wagiminator/ATtiny13-TinyDice/documentation/TinyDice_pic2.jpg

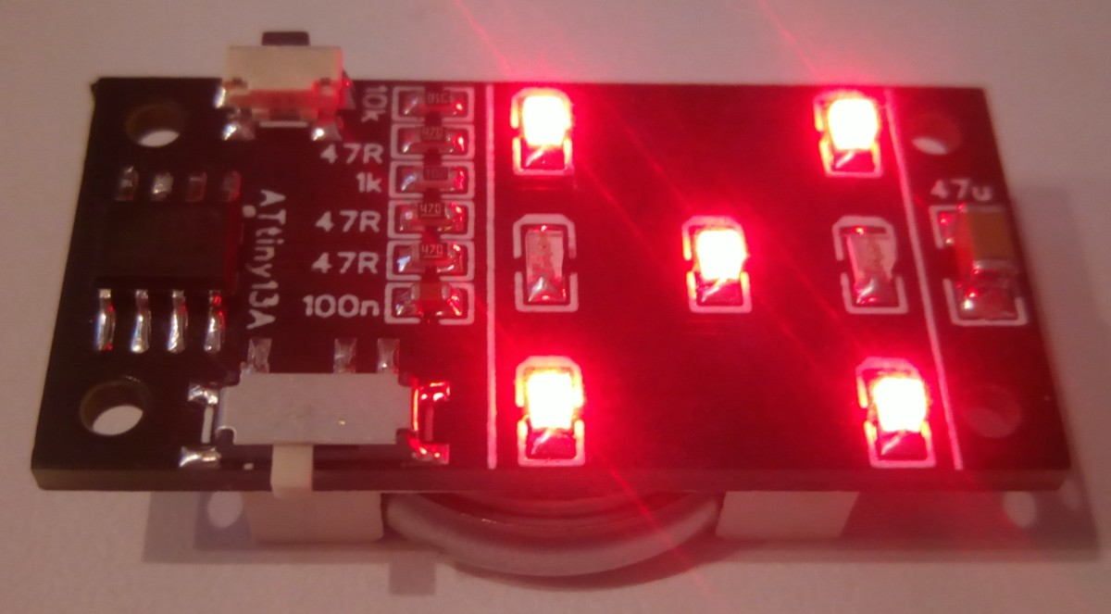
documentation/TinyDice_pic2.jpg
