wagiminator/ATtiny13-TinyDice/hardware/tinyDice_BOM_v1.0.tsv

ID | Name | Designator | Footprint | Quantity | Manufacturer Part | Manufacturer | Supplier | Supplier Part
1 | MSK-11027 | KEY1 | MSK-11027 | 1 | MSK-11027 Toggle Switches | ReliaPro | LCSC | C21381
2 | TS24CA | KEY2 | SW-SMD_TS24CA | 1 | TS24CA | SHOU HAN | LCSC | C393942
3 | 47R | R5,R4,R3 | 0603 | 3 | 0603WAF470JT5E | UniOhm | LCSC | C23182
4 | 10k | R1 | 0603 | 1 | 0603WAF1002T5E | UniOhm | LCSC | C25804
5 | 1k | R2 | 0603 | 1 | 0603WAF1001T5E | UniOhm | LCSC | C21190
6 | CR2032-BS-6-1 | B1 | BATTERY-3 | 1 | CR2032-BS-6-1 | Q&J | LCSC | C70377
7 | Red | LED2,LED3,LED6,LED7,LED4,LED1,LED5 | LED-0805 | 7 | KT-0603R | KENTO | LCSC | C2286
8 | 100n | C1 | 0603 | 1 | CC0603KRX7R9BB104 | YAGEO | LCSC | C14663
9 | 47u | C2 | 1206 | 1 | 1206F476M160NT | FH | LCSC | C30300
10 | ATTINY13A-SSU | U1 | SOIC-8_150MIL | 1 | ATTINY13A-SSU | MICROCHIP | LCSC | C14075
