wagiminator/ATtiny13-TinyDice/hardware/tinyDice_schematic_v1.0.pdf

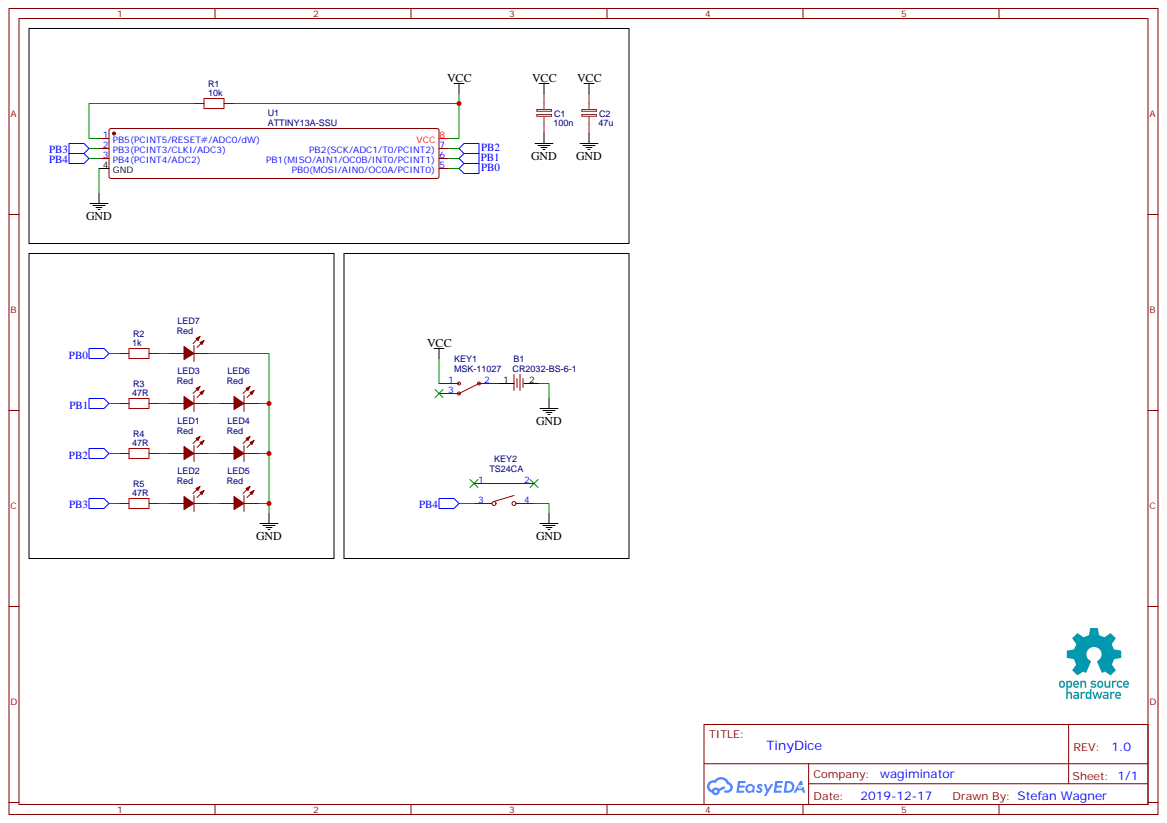
[picture p6: page 1]

Drawn By: Stefan Wagner
